Goofyeet/IR-Remote/README.md

# IR-Remote

In this project I wrote some AVR assembly code for an ATTiny 12V microcontroller to control a tower fan. I used an oscilloscope to reverse engineer the original remotes signals.

Check out the remote in action in the media folder!

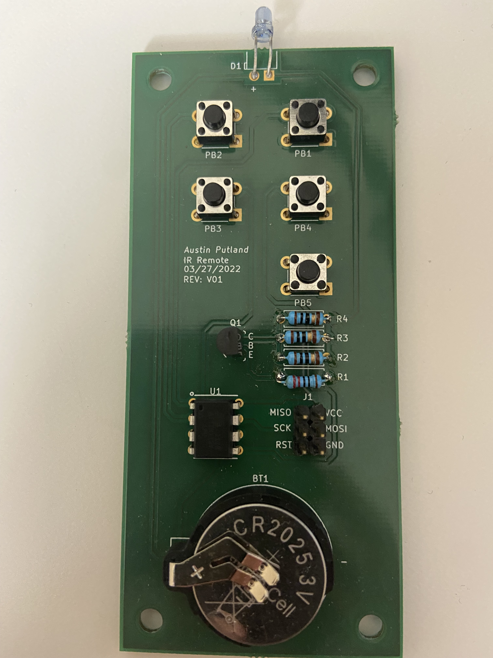
[picture p1: Media/Built-PCB.jpg]
Remote PCB
