Goofyeet/IR-Remote/Kicad/IR_Remote/IR_Remote.kicad_pcb

## KiCad design Kicad/IR_Remote/IR_Remote.kicad_pcb (2022-05-08)

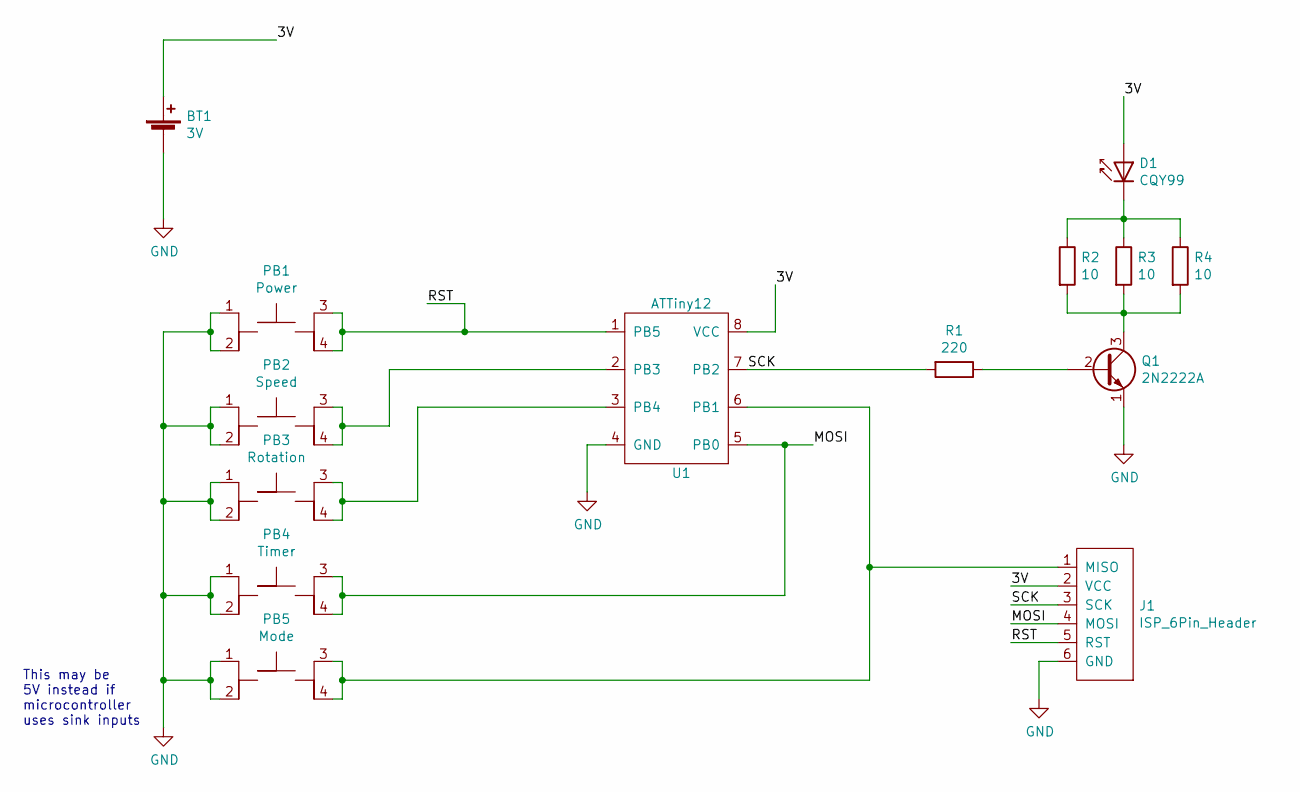
[picture p2: schematic IR_Remote.sch]

Parts:
BT1: 3V; CR2032_BH-124A-1
D1: CQY99; LED_D5.0mm_Horizontal_O1.27mm_Z3.0mm_IRGrey
J1: ISP_6Pin_Header; 2X3_ICSP_Header
PB1: Power; Switch_Tactile_THT_6x6mm
PB2: Speed; Switch_Tactile_THT_6x6mm
PB3: Rotation; Switch_Tactile_THT_6x6mm
PB4: Timer; Switch_Tactile_THT_6x6mm
PB5: Mode; Switch_Tactile_THT_6x6mm
Q1: 2N2222A; TO-92-3
R1: 220; R_Axial_DIN0207_L6.3mm_D2.5mm_P7.62mm_Horizontal
R2, R3, R4: 10; R_Axial_DIN0207_L6.3mm_D2.5mm_P7.62mm_Horizontal
U1: ATTiny12

Connections:
/3V: BT1.1 (+), D1.2 (A), J1.2 (VCC), U1.8 (VCC)
/MOSI: J1.4 (MOSI), PB4.3, PB4.4, U1.5 (PB0)
/RST: J1.5 (RST), PB1.3, PB1.4, U1.1 (PB5)
/SCK: J1.3 (SCK), R1.2, U1.7 (PB2)
GND: BT1.2 (-), J1.6 (GND), PB1.1, PB1.2, PB2.1, PB2.2, PB3.1, PB3.2, PB4.1, PB4.2, PB5.1, PB5.2, Q1.1 (E), U1.4 (GND)
unnamed: D1.1 (K), R2.1, R3.1, R4.1
unnamed: J1.1 (MISO), PB5.3, PB5.4, U1.6 (PB1)
unnamed: PB2.3, PB2.4, U1.2 (PB3)
unnamed: PB3.3, PB3.4, U1.3 (PB4)
unnamed: Q1.2 (B), R1.1
unnamed: Q1.3 (C), R2.2, R3.2, R4.2

Notes on the sheet:
This may be 5V instead if microcontroller uses sink inputs

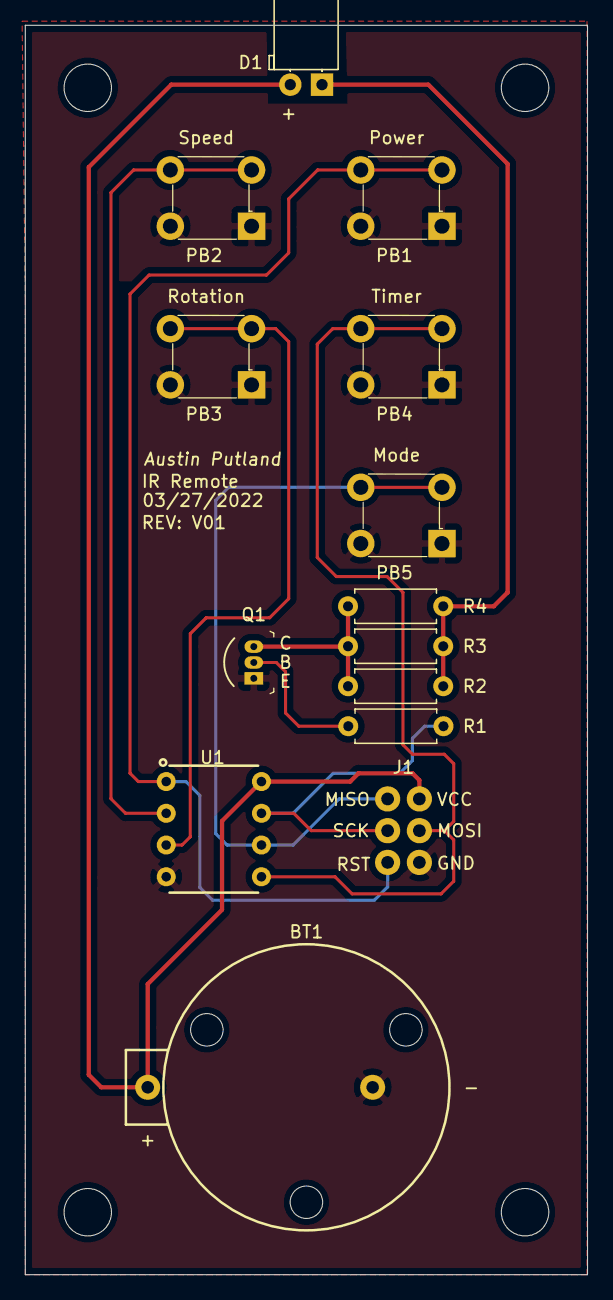
[picture p3: board IR_Remote.kicad_pcb from above]

Board: 2 copper layers, 45.0 x 100.0 mm, 14 parts (0 on the bottom side), 11 nets.
