Goofyeet/IR-Remote/(commit log)

2022-05-08 added Kicad folder
    [IR_Remote.kicad_pcb, IR_Remote.sch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]
2022-05-23 add register values spreadsheet
    [Register values.xlsx]
2022-05-23 add assembly code file
2022-05-23 added HVSP fuse reset file
    [HVSP_Reset_fuse_bits.ino]
2022-05-23 added arduino IR receive and send code
2022-05-24 enables sleep mode before interrupt enable, fixes interrupt on powerup
    [IR_Remote.asm]
